hunter-morse/canOpener/docs/canLogo.pdf

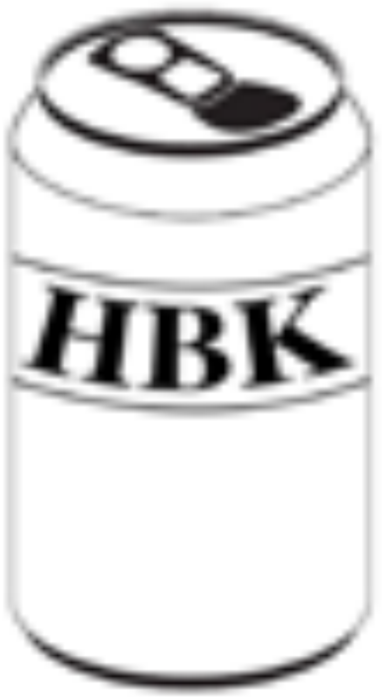
[picture p1: page 1]
