hunter-morse/canOpener/Soda_Popper.brd

## EAGLE design Soda_Popper.brd (2021-12-07)

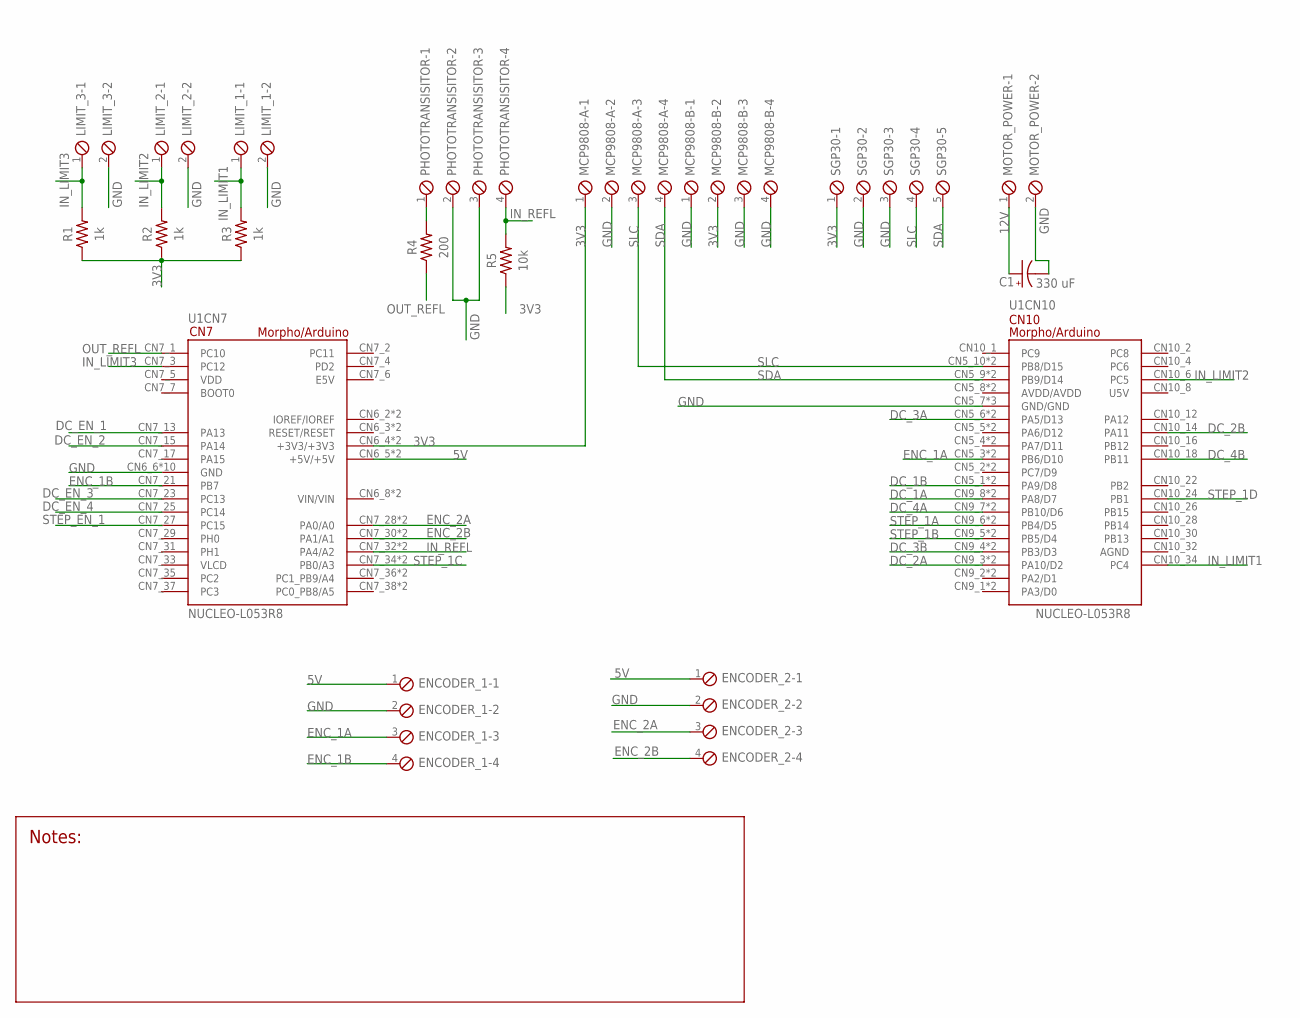
[picture p2: schematic Soda_Popper.sch, sheet 1]

Parts:
C1: 330 uF; CAPPRD508W65D1000H1100B
ENCODER_1, ENCODER_2: SCREWTERM_4P_254; 4POL254
LIMIT_1, LIMIT_2, LIMIT_3: SCREWTERM_2P_254; 2POL254
MCP9808-A, MCP9808-B: SCREWTERM_4P_254; 4POL254
MOTOR_POWER: SCREWTERM_2P_508; 2POL508
PHOTOTRANSISITOR: SCREWTERM_4P_254; 4POL254
R1, R2, R3: 1k; RESC3216X70
R4: 200; RESC3216X70
R5: 10k; RESC2012X65
SGP30: SCREWTERM_5P_254; 5POL254
U1: NUCLEO-L053R8; MODULE_NUCLEO-L053R8

Connections:
3V3: MCP9808-A.1, MCP9808-B.2, R1.1, R2.1, R3.1, R5.1, SGP30.1, U1.CN6_4 (+3V3/+3V3), U1.CN7_16 (+3V3/+3V3)
5V: ENCODER_1.1, ENCODER_2.1, U1.CN6_5 (+5V/+5V), U1.CN7_18 (+5V/+5V); also elsewhere on the board
12V: C1.1 (+), MOTOR_POWER.1; also elsewhere on the board
DC_1A: U1.CN9_8 (PA8/D7), U1.CN10_23 (PA8/D7); also elsewhere on the board
DC_1B: U1.CN5_1 (PA9/D8), U1.CN10_21 (PA9/D8); also elsewhere on the board
DC_2A: U1.CN9_3 (PA10/D2), U1.CN10_33 (PA10/D2); also elsewhere on the board
DC_2B: U1.CN10_14 (PA11); also elsewhere on the board
DC_3A: U1.CN5_6 (PA5/D13), U1.CN10_11 (PA5/D13); also elsewhere on the board
DC_3B: U1.CN9_4 (PB3/D3), U1.CN10_31 (PB3/D3); also elsewhere on the board
DC_4A: U1.CN9_7 (PB10/D6), U1.CN10_25 (PB10/D6); also elsewhere on the board
DC_4B: U1.CN10_18 (PB11); also elsewhere on the board
DC_EN_1: U1.CN7_13 (PA13); also elsewhere on the board
DC_EN_2: U1.CN7_15 (PA14); also elsewhere on the board
DC_EN_3: U1.CN7_23 (PC13); also elsewhere on the board
DC_EN_4: U1.CN7_25 (PC14); also elsewhere on the board
ENC_1A: ENCODER_1.3, U1.CN5_3 (PB6/D10), U1.CN10_17 (PB6/D10)
ENC_1B: ENCODER_1.4, U1.CN7_21 (PB7)
ENC_2A: ENCODER_2.3, U1.CN7_28 (PA0/A0), U1.CN8_1 (PA0/A0)
ENC_2B: ENCODER_2.4, U1.CN7_30 (PA1/A1), U1.CN8_2 (PA1/A1)
GND: C1.2 (-), ENCODER_1.2, ENCODER_2.2, LIMIT_1.2, LIMIT_2.2, LIMIT_3.2, MCP9808-A.2, MCP9808-B.1, MCP9808-B.3, MCP9808-B.4, MOTOR_POWER.2, PHOTOTRANSISITOR.2, PHOTOTRANSISITOR.3, SGP30.2, SGP30.3, U1.CN5_7 (GND/GND), U1.CN6_6 (GND), U1.CN6_7 (GND), U1.CN7_8 (GND), U1.CN7_19 (GND), U1.CN7_20 (GND), U1.CN7_22 (GND), U1.CN10_9 (GND/GND), U1.CN10_20 (GND/GND), U1.CN11_1 (GND), U1.CN11_2 (GND), U1.CN12_1 (GND), U1.CN12_2 (GND); also elsewhere on the board
IN_LIMIT1: LIMIT_1.1, R3.2, U1.CN10_34 (PC4)
IN_LIMIT2: LIMIT_2.1, R2.2, U1.CN10_6 (PC5)
IN_LIMIT3: LIMIT_3.1, R1.2, U1.CN7_3 (PC12)
IN_REFL: PHOTOTRANSISITOR.4, R5.2, U1.CN7_32 (PA4/A2), U1.CN8_3 (PA4/A2)
unnamed: PHOTOTRANSISITOR.1, R4.2
OUT_REFL: R4.1, U1.CN7_1 (PC10)
SDA: MCP9808-A.4, SGP30.5, U1.CN5_9 (PB9/D14), U1.CN10_5 (PB9/D14)
SLC: MCP9808-A.3, SGP30.4, U1.CN5_10 (PB8/D15), U1.CN10_3 (PB8/D15)
STEP_1A: U1.CN9_6 (PB4/D5), U1.CN10_27 (PB4/D5); also elsewhere on the board
STEP_1B: U1.CN9_5 (PB5/D4), U1.CN10_29 (PB5/D4); also elsewhere on the board
STEP_1C: U1.CN7_34 (PB0/A3), U1.CN8_4 (PB0/A3); also elsewhere on the board
STEP_1D: U1.CN10_24 (PB1); also elsewhere on the board
STEP_EN_1: U1.CN7_27 (PC15); also elsewhere on the board

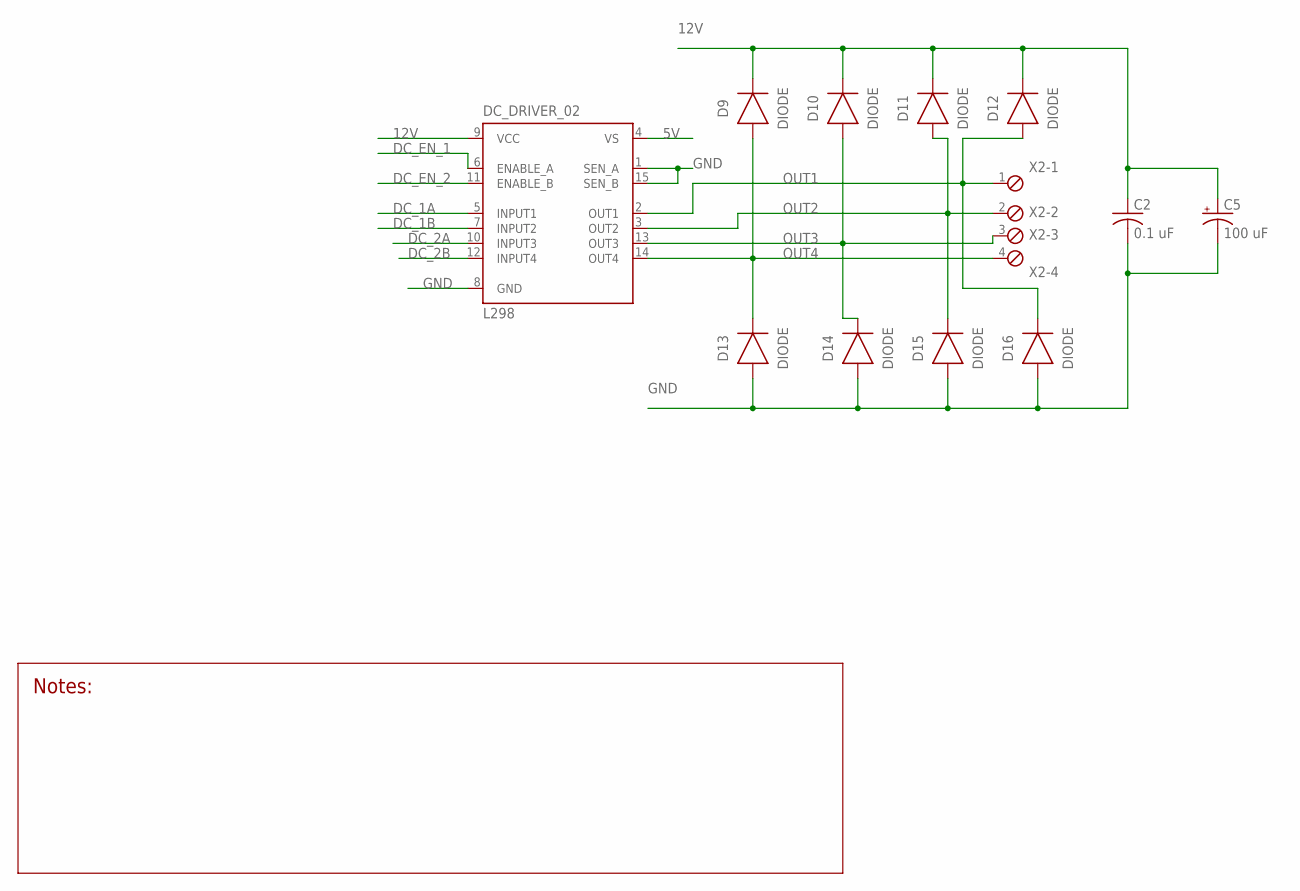
[picture p3: schematic Soda_Popper.sch, sheet 2]

Parts:
C2: 0.1 uF; CAPC2012X110
C5: 100 uF; CAPPRD508W65D1000H1100B
D9, D10, D11, D12, D13, D14, D15, D16: DIODE; DIOM5336X265N
DC_DRIVER_02: L298; MULTIWATT-15
X2: SCREWTERM_4P_508; 4POL508

Connections:
5V: DC_DRIVER_02.4 (VS); also elsewhere on the board
12V: C2.1, C5.1 (+), D9.1 (C), D10.1 (C), D11.1 (C), D12.1 (C), DC_DRIVER_02.9 (VCC); also elsewhere on the board
DC_1A: DC_DRIVER_02.5 (INPUT1); also elsewhere on the board
DC_1B: DC_DRIVER_02.7 (INPUT2); also elsewhere on the board
DC_2A: DC_DRIVER_02.10 (INPUT3); also elsewhere on the board
DC_2B: DC_DRIVER_02.12 (INPUT4); also elsewhere on the board
DC_EN_1: DC_DRIVER_02.6 (ENABLE_A); also elsewhere on the board
DC_EN_2: DC_DRIVER_02.11 (ENABLE_B); also elsewhere on the board
GND: C2.2, C5.2 (-), D13.2 (A), D14.2 (A), D15.2 (A), D16.2 (A), DC_DRIVER_02.1 (SEN_A), DC_DRIVER_02.8 (GND), DC_DRIVER_02.15 (SEN_B); also elsewhere on the board
OUT1: D12.2 (A), D16.1 (C), DC_DRIVER_02.2 (OUT1), X2.1
OUT2: D11.2 (A), D15.1 (C), DC_DRIVER_02.3 (OUT2), X2.2
OUT3: D10.2 (A), D14.1 (C), DC_DRIVER_02.13 (OUT3), X2.3
OUT4: D9.2 (A), D13.1 (C), DC_DRIVER_02.14 (OUT4), X2.4

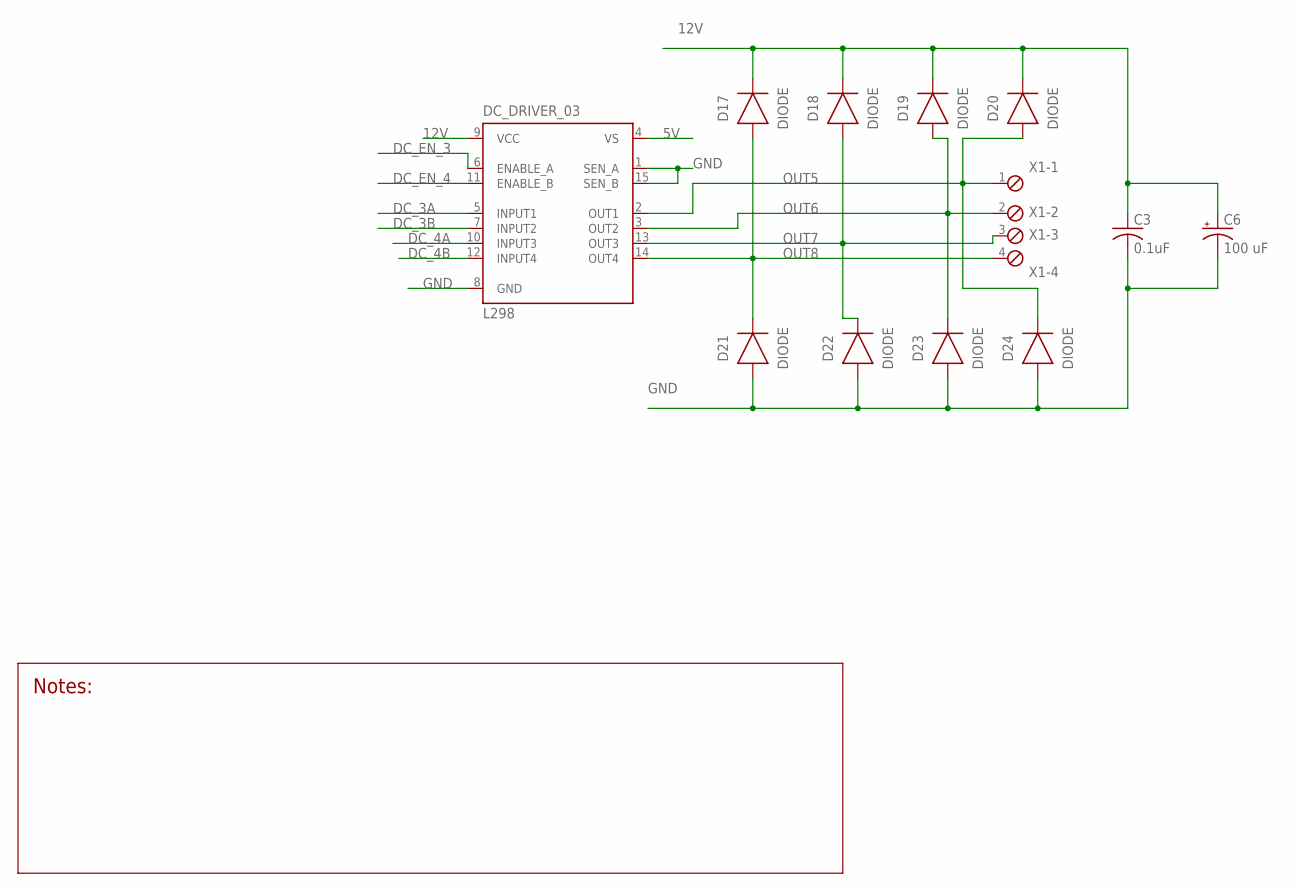
[picture p4: schematic Soda_Popper.sch, sheet 3]

Parts:
C3: 0.1uF; CAPC2012X110
C6: 100 uF; CAPPRD508W65D1000H1100B
D17, D18, D19, D20, D21, D22, D23, D24: DIODE; DIOM5336X265N
DC_DRIVER_03: L298; MULTIWATT-15
X1: SCREWTERM_4P_508; 4POL508

Connections:
5V: DC_DRIVER_03.4 (VS); also elsewhere on the board
12V: C3.1, C6.1 (+), D17.1 (C), D18.1 (C), D19.1 (C), D20.1 (C), DC_DRIVER_03.9 (VCC); also elsewhere on the board
DC_3A: DC_DRIVER_03.5 (INPUT1); also elsewhere on the board
DC_3B: DC_DRIVER_03.7 (INPUT2); also elsewhere on the board
DC_4A: DC_DRIVER_03.10 (INPUT3); also elsewhere on the board
DC_4B: DC_DRIVER_03.12 (INPUT4); also elsewhere on the board
DC_EN_3: DC_DRIVER_03.6 (ENABLE_A); also elsewhere on the board
DC_EN_4: DC_DRIVER_03.11 (ENABLE_B); also elsewhere on the board
GND: C3.2, C6.2 (-), D21.2 (A), D22.2 (A), D23.2 (A), D24.2 (A), DC_DRIVER_03.1 (SEN_A), DC_DRIVER_03.8 (GND), DC_DRIVER_03.15 (SEN_B); also elsewhere on the board
OUT5: D20.2 (A), D24.1 (C), DC_DRIVER_03.2 (OUT1), X1.1
OUT6: D19.2 (A), D23.1 (C), DC_DRIVER_03.3 (OUT2), X1.2
OUT7: D18.2 (A), D22.1 (C), DC_DRIVER_03.13 (OUT3), X1.3
OUT8: D17.2 (A), D21.1 (C), DC_DRIVER_03.14 (OUT4), X1.4

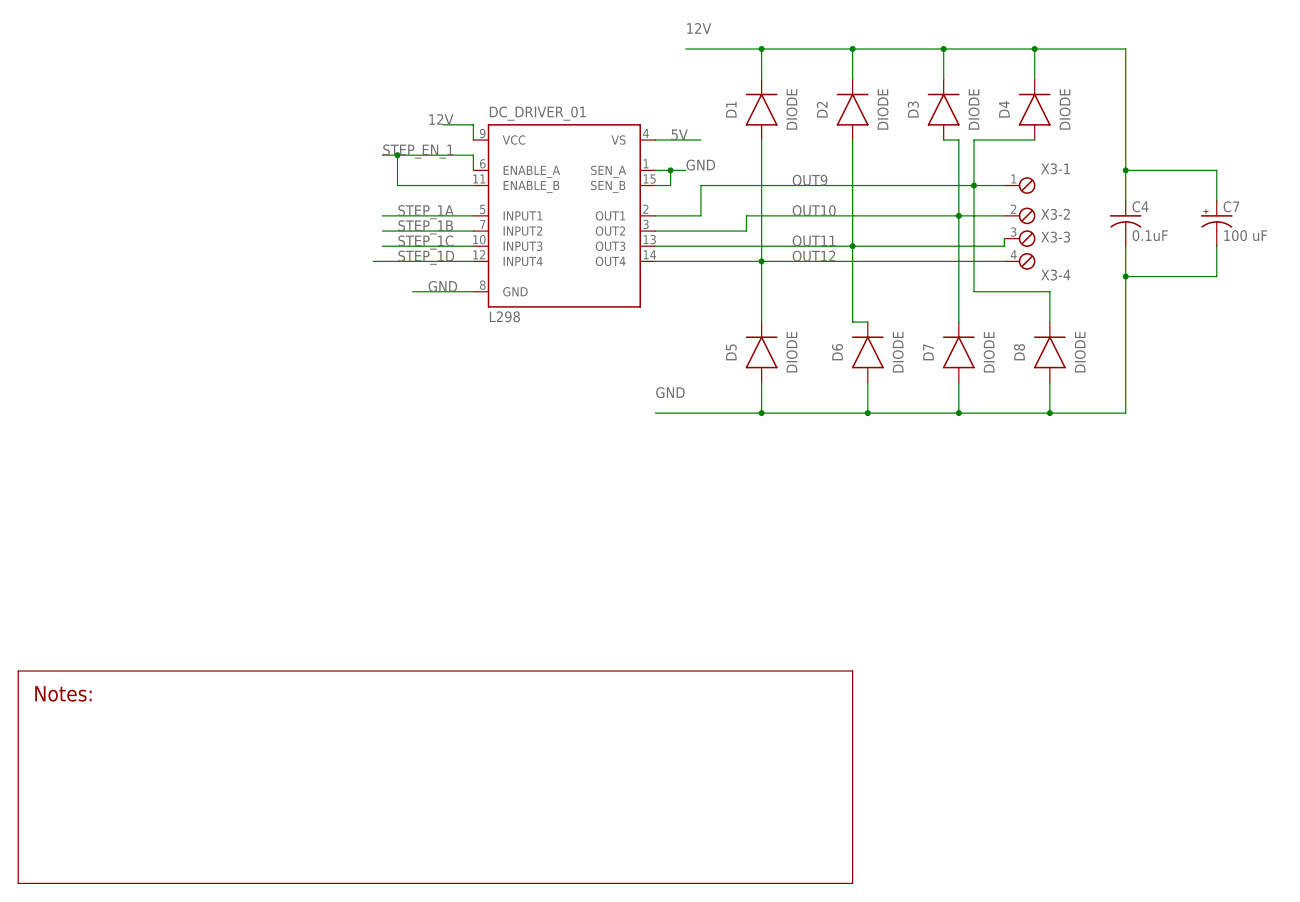
[picture p5: schematic Soda_Popper.sch, sheet 4]

Parts:
C4: 0.1uF; CAPC2012X110
C7: 100 uF; CAPPRD508W65D1000H1100B
D1, D2, D3, D4, D5, D6, D7, D8: DIODE; DIOM5336X265N
DC_DRIVER_01: L298; MULTIWATT-15
X3: SCREWTERM_4P_508; 4POL508

Connections:
5V: DC_DRIVER_01.4 (VS); also elsewhere on the board
12V: C4.1, C7.1 (+), D1.1 (C), D2.1 (C), D3.1 (C), D4.1 (C), DC_DRIVER_01.9 (VCC); also elsewhere on the board
GND: C4.2, C7.2 (-), D5.2 (A), D6.2 (A), D7.2 (A), D8.2 (A), DC_DRIVER_01.1 (SEN_A), DC_DRIVER_01.8 (GND), DC_DRIVER_01.15 (SEN_B); also elsewhere on the board
OUT9: D4.2 (A), D8.1 (C), DC_DRIVER_01.2 (OUT1), X3.1
OUT10: D3.2 (A), D7.1 (C), DC_DRIVER_01.3 (OUT2), X3.2
OUT11: D2.2 (A), D6.1 (C), DC_DRIVER_01.13 (OUT3), X3.3
OUT12: D1.2 (A), D5.1 (C), DC_DRIVER_01.14 (OUT4), X3.4
STEP_1A: DC_DRIVER_01.5 (INPUT1); also elsewhere on the board
STEP_1B: DC_DRIVER_01.7 (INPUT2); also elsewhere on the board
STEP_1C: DC_DRIVER_01.10 (INPUT3); also elsewhere on the board
STEP_1D: DC_DRIVER_01.12 (INPUT4); also elsewhere on the board
STEP_EN_1: DC_DRIVER_01.6 (ENABLE_A), DC_DRIVER_01.11 (ENABLE_B); also elsewhere on the board

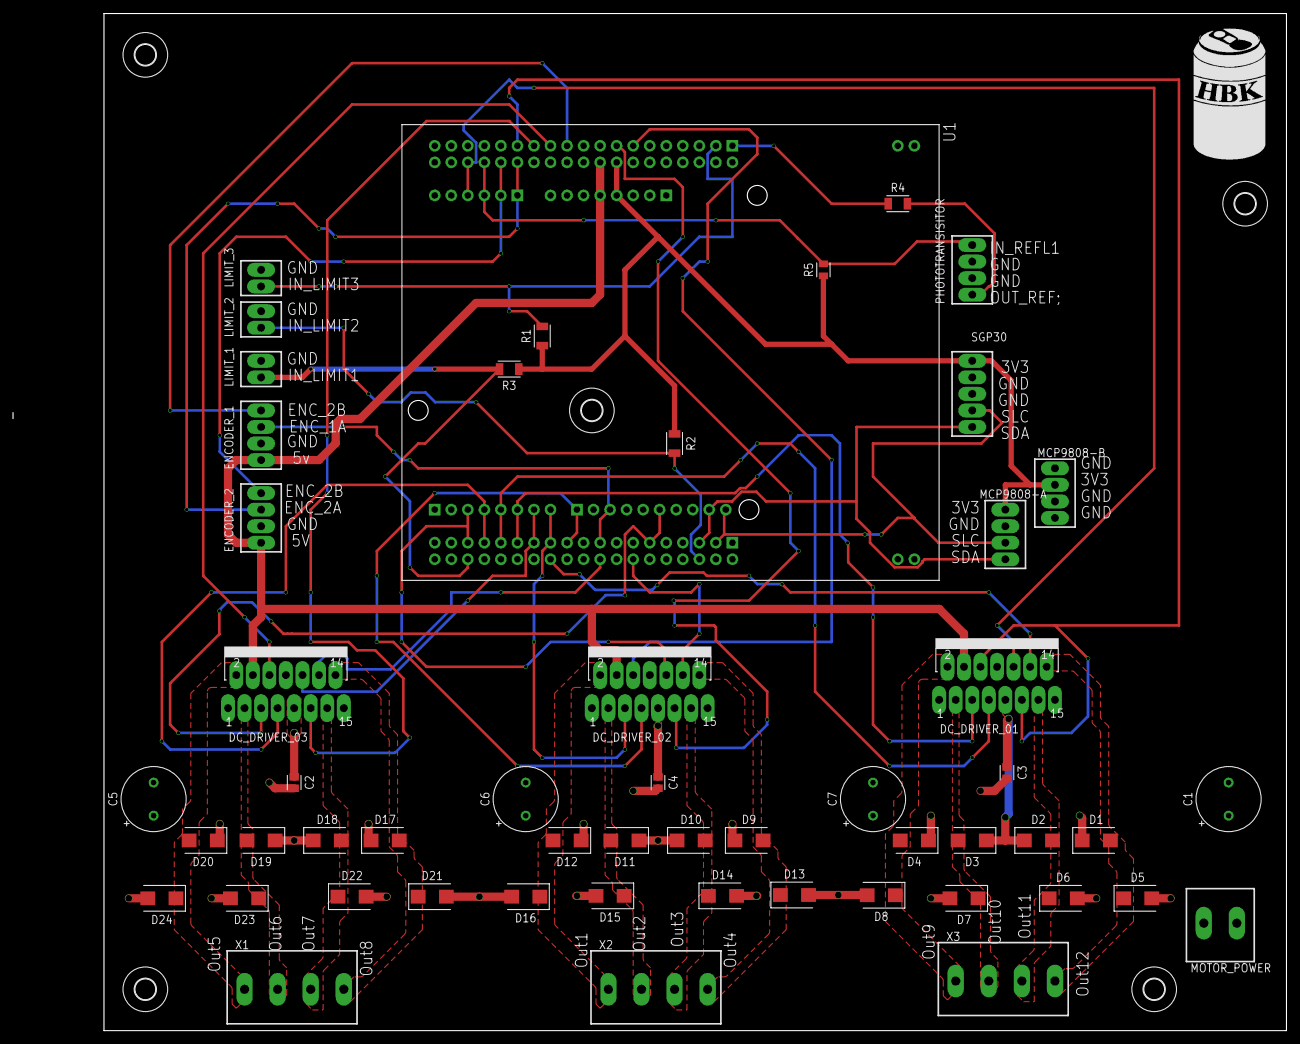
[picture p6: board Soda_Popper.brd from above]

Board: 2 copper layers, 195.6 x 156.2 mm, 58 parts (0 on the bottom side), 45 nets.

Other parts of the board:
U$1, U$2, U$3, U$4, U$5: 3,2
