hunter-morse/canOpener/CanOpener/src/tasks/taskEncoder.h

/**
 * @file    taskEncoder.h
 *          Encoder task .h file
 * @author  Ben Bons
 * @date    Dec 01, 2021
 */

#ifndef TASKENCODER_H
#define TASKENCODER_H

#include <Arduino.h>
#include <STM32FreeRTOS.h>
#include <PrintStream.h>
#include "../shares.h"
#include "../pins.h"

void taskEncoder(void* p_params);
int64_t fixDelta(int64_t delta, uint32_t period);

#endif
