hunter-morse/canOpener/CanOpener/src/tasks/taskMoveMachine.h

/**
 * @file    taskMoveMachine.h
 *          Machine movement task .h file
 * @author  Hunter Morse
 * @date    Nov 30, 2021
 */ 

#ifndef TASK_MOVE_MACHINE_H
#define TASK_MOVE_MACHINE_H

#include "STM32FreeRTOS.h"
#include <Arduino.h>
#include "PrintStream.h"
#include "taskshare.h"
#include "../lib/motorDriverLib/MotorDriver.h"
#include "../lib/motorDriverLib/StepperDriver.h"
#include "../shares.h"
#include "../pins.h"

void taskMoveMachine(void *p_params);

#endif
