hunter-morse/canOpener/CanOpener/src/tasks/taskLimitSwitch.h

/**
 * @file    taskLimitSwitch.h
 *          Limit switch checker task .h file
 * @author  Hunter Morse
 * @date    Nov 30, 2021
 */ 

#ifndef TASK_LIMIT_SWITCH_H
#define TASK_LIMIT_SWITCH_H

#include "STM32FreeRTOS.h"
#include <Arduino.h>
#include "PrintStream.h"
#include "taskshare.h"
#include "../lib/sensorLib/limitSwitch.h"
#include "../shares.h"
#include "../pins.h"

void taskCheckLimitSwitches(void *p_params);

#endif
