hunter-morse/canOpener/CanOpener/src/tasks/taskTemp.h

/**
 * @file taskTemp.h
 * @brief Header file for the taskTemp task
 * 
 * @author Ben Bons
 * @date Nov 27, 2021
 * 
 * */
#ifndef TASK_TEMP_H
#define TASK_TEMP_H

void taskTemp(void* p_params);

#endif
