hunter-morse/canOpener/CanOpener/src/tasks/taskWriteToDisplay.h

/**
 * @file taskWriteToDisplay.h
 * @brief Header file for taskWriteToDisplay
 * 
 * @author Ben Bons
 * @date Nov 27, 2021
 * */

#ifndef TASKWRITETODISPLAY_H
#define TASKWRITETODISPLAY_H

void taskWriteToDisplay(void* p_params);

#endif
