hunter-morse/canOpener/(commit log)

2021-11-11 Example of using the Wire class to perform I2C comms
2021-11-15 Created a working driver for the MCP9808 temperature sensor
2021-11-18 Beginning of Stepper Motor Driver
2021-11-18 Added all functions to the Stepper Motor Driver - This was done in class so I will go back to look at it closer
2021-11-18 Started documentation for the StepperDriver class
2021-11-19 Finished documentation for the StepperDriver class
2021-11-19 Started on servo motor driver
2021-11-20 Added major functionality to the MotorDriver class. At this point there are no getters or setters, and the code needs to be tested
2021-11-27 motor driver
2021-11-28 Started work on the temp sensor task
2021-11-28 Working on tasks. Seems to have some errors with taskShare.h
    [taskWriteToDisplay.cpp, taskWriteToDisplay.h]
2021-11-29 Fixed compile errors - needed more includes and reorder of the ones that were there
    [taskTemp.cpp, taskWriteToDisplay.cpp]
2021-11-29 Added getters to the MotorDriver class
2021-11-29 Checked functionality of the MotorDriver class
2021-11-29 Tested StepperDriver class
2021-11-30 Testing the stepper motor
2021-11-30 This main file is now ready for testing the stepper motor
2021-11-30 Added main.cpp and fixed include errors at compile
    [main.cpp, shares.h, taskTemp.cpp]
2021-11-30 Documentation for the MotorDriver class
2021-11-30 Documentation for the Temp Sensor class
2021-12-01 current limit switch task is more of a machine operation task so I need to switch that around
2021-12-01 limitSwitch task complete and machine move task in the works. project currently compiles without errors
    [main.cpp, pins.h, taskLimitSwitch.cpp, taskMoveMachine.cpp, taskMoveMachine.h]
2021-12-01 Added encoders to pins.h
2021-12-02 fixed encoder compile
2021-12-02 At this moment, a lot is commented out but the limit switches are working
2021-12-02 figuring out why upload won't work
    [main.cpp, taskLimitSwitch.cpp]
2021-12-02 Working Stepper motor
2021-12-02 This is currently working. Using 2 limit switches, we can control moving the platform down, and then moving it back up. Next step is working on the photo interrupt
2021-12-02 Added kill switch and platform raise. Working at this point
2021-12-07 reset motor base changes pushed
    [taskEncoder.cpp, taskEncoder.h, taskMoveMachine.cpp]
2021-12-07 Added board and schematic
    [Soda_Popper.brd, Soda_Popper.sch]
